hermes170172/arduino-receptor-RF-433MHZ-4-canais-/esquemas/esquema elétrico.PDF

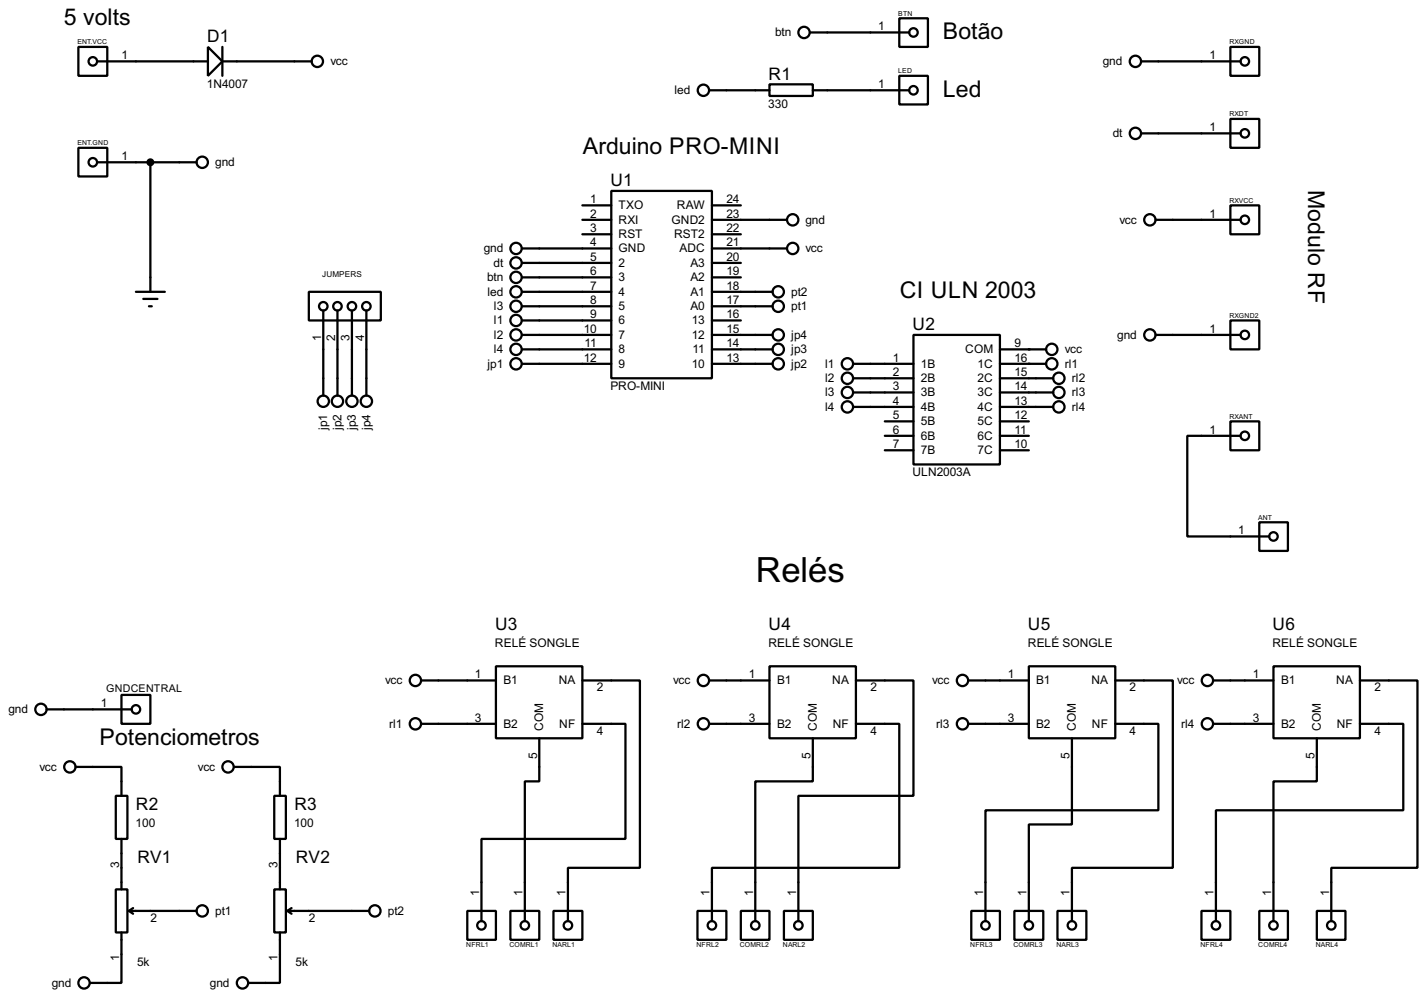
[picture p4: page 1]
