hermes170172/arduino-receptor-RF-433MHZ-4-canais-/(list of files, drawings)

Other design files:
arquivos proteus/proteus/RX_4CH.pdsprj
